mczerski/MySXActuator/exports/MySXActuator.png

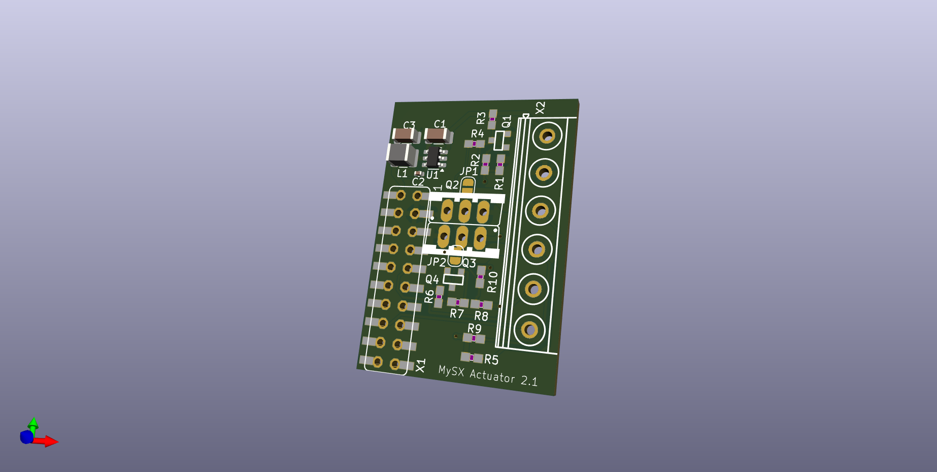
exports/MySXActuator.png
