mczerski/MySXActuator/3dshapes/G5RL_U1A_E.step

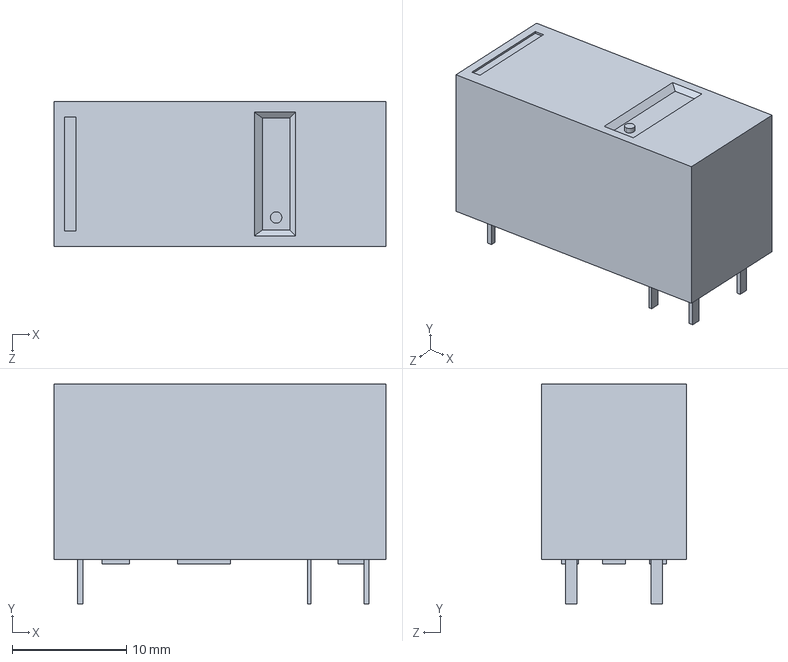
[picture p2: CAD file, 2024-06-08]
3dshapes/G5RL_U1A_E.step
29.0 x 19.2 x 12.7 mm
