mczerski/MySXActuator/3dshapes/54601-908WPLF.step

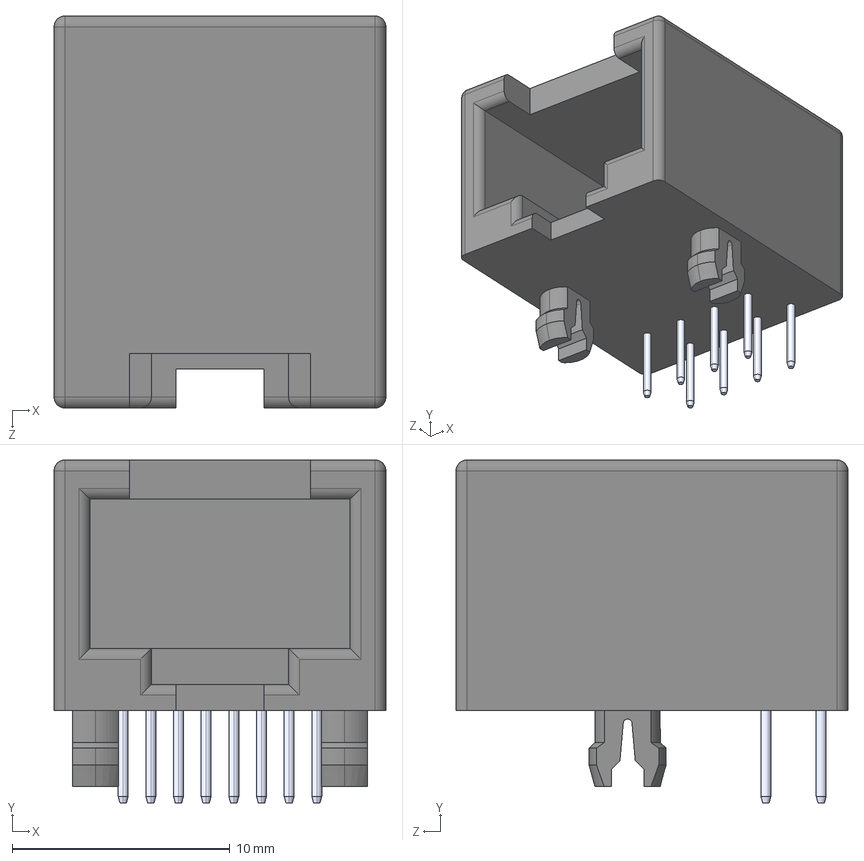
[picture p3: CAD file, 2024-07-27]
3dshapes/54601-908WPLF.step
15.2 x 15.8 x 18.0 mm
