mczerski/MySXActuator/MySXActuator.pdf

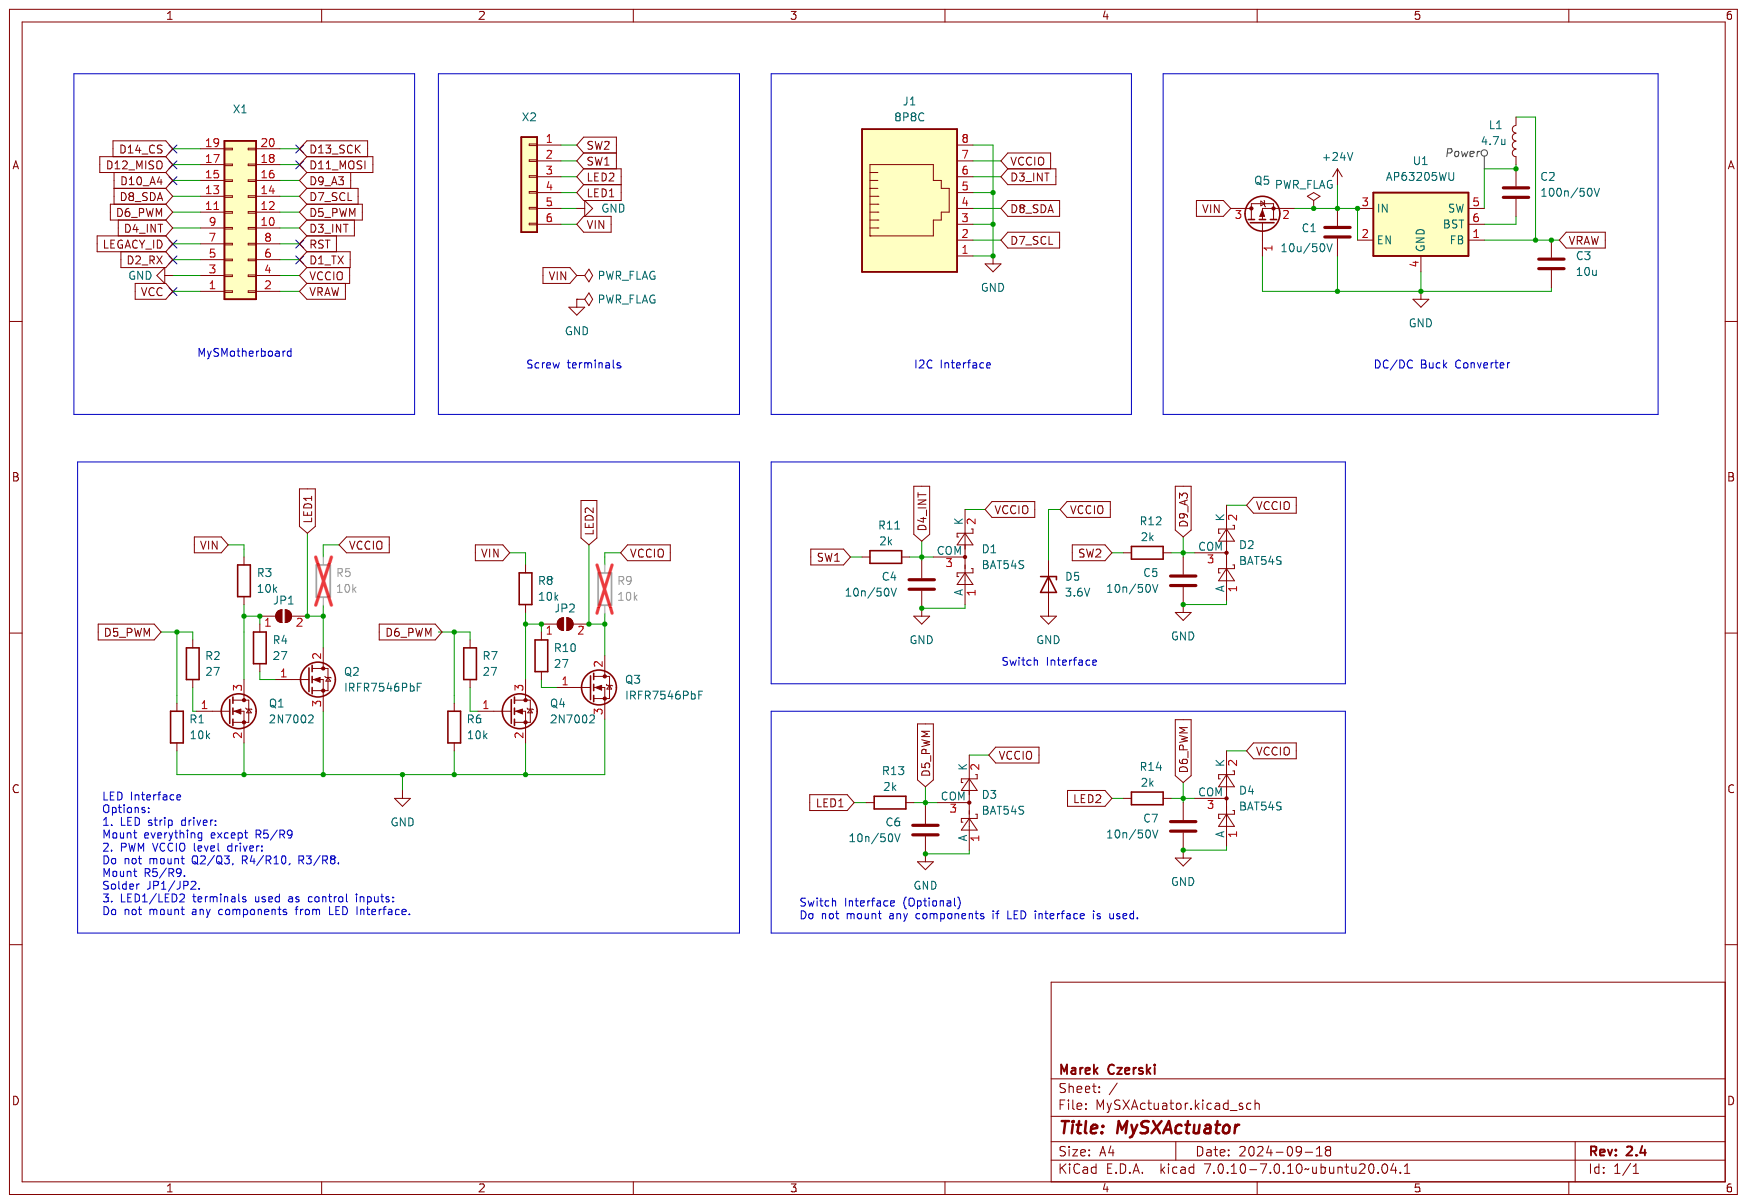
[picture p4: page 1]
