mczerski/MySXActuator/MySXActuator.kicad_pcb

## KiCad design MySXActuator.kicad_pcb (2026-06-14)

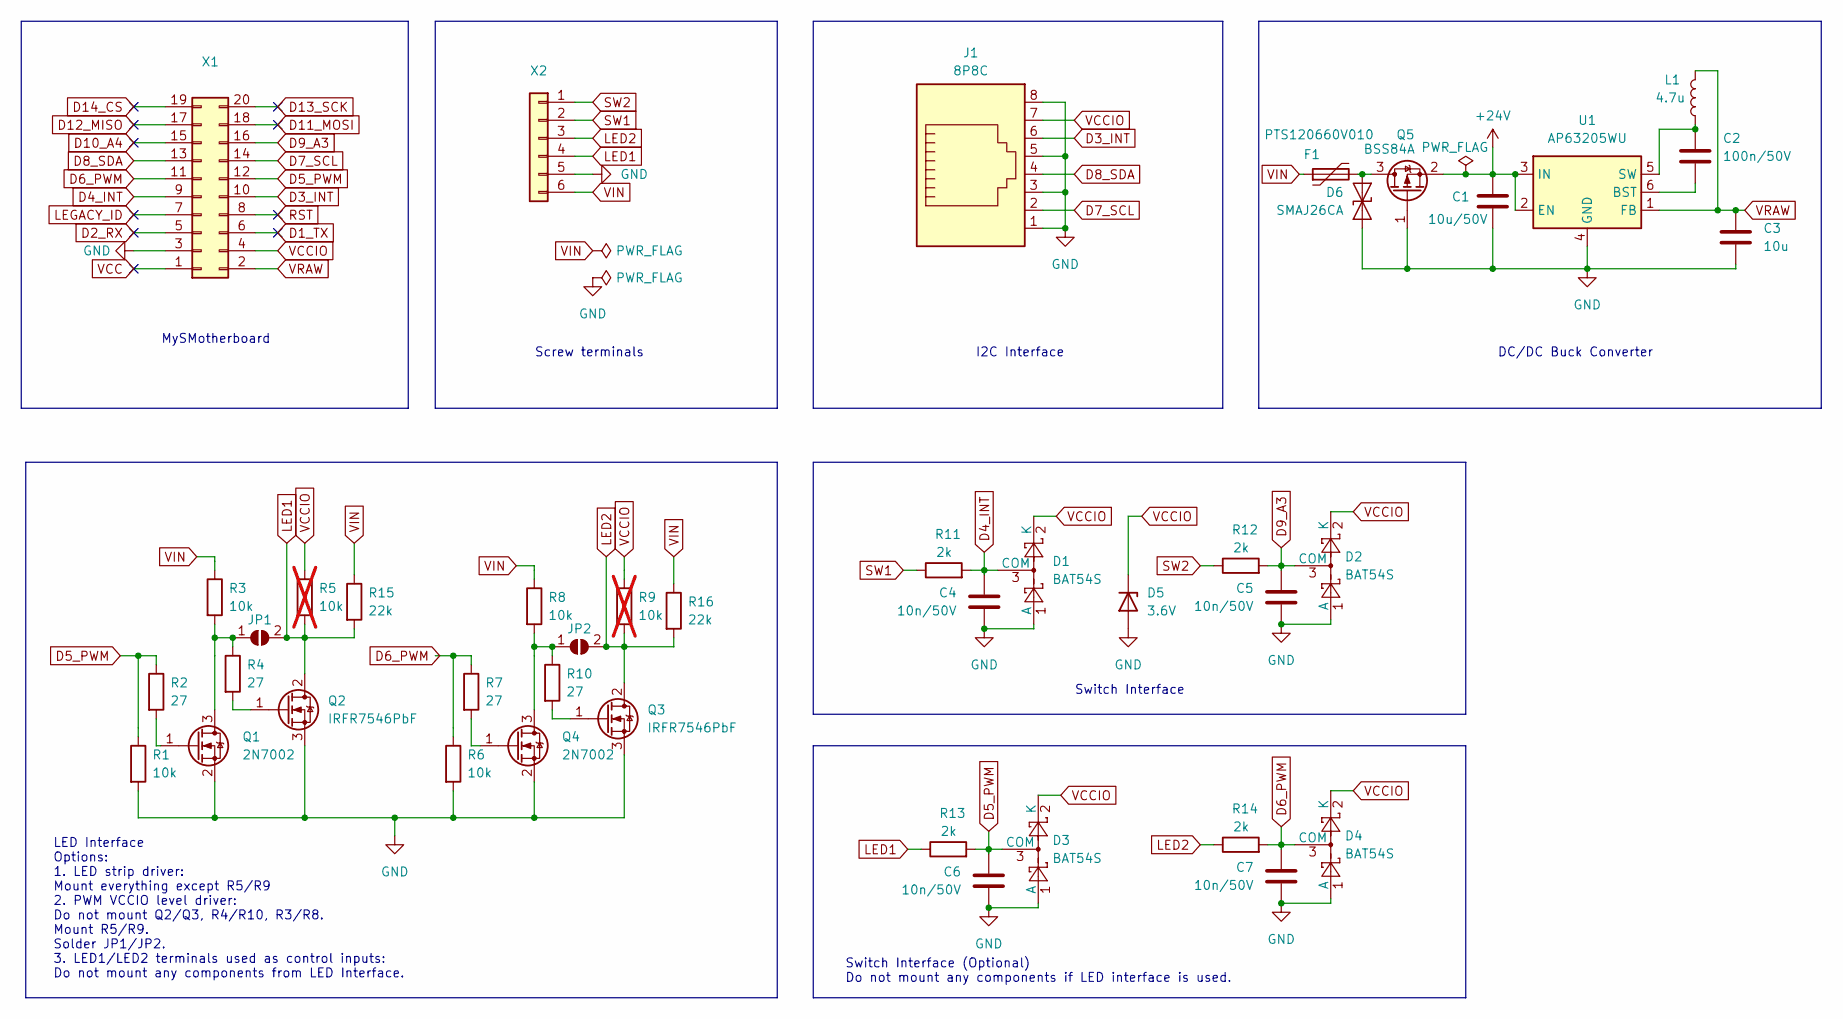
[picture p5: schematic MySXActuator.kicad_sch]

Parts:
C1: 10u/50V; C_1206_3216Metric
C2: 100n/50V; C_0402_1005Metric_Pad0.74x0.62mm_HandSolder
C3: 10u; C_1206_3216Metric
C4, C5, C6, C7: 10n/50V; C_0402_1005Metric
D1, D2, D3, D4: BAT54S; SOT-23
D5: 3.6V; D_MiniMELF
D6: SMAJ26CA; D_SMA
F1: PTS120660V010; Fuse_1206_3216Metric_Pad1.42x1.75mm_HandSolder
J1: 8P8C; AMPHENOL_54601-908WPLF
JP1, JP2: SolderJumper-2_P1.3mm_Open_RoundedPad1.0x1.5mm
L1: 4.7u; L_1210_3225Metric
Q1, Q4: 2N7002; SOT-23
Q2, Q3: IRFR7546PbF; TO-252-2
Q5: BSS84A; SOT-23
R1, R3, R6, R8: 10k; R_0603_1608Metric
R2, R4, R7, R10: 27; R_0603_1608Metric
R5, R9: 10k; R_0603_1608Metric; not fitted
R11, R12, R13, R14: 2k; R_0603_1608Metric
R15, R16: 22k; R_0603_1608Metric
U1: AP63205WU; TSOT-23-6
X1: FE10-2
X2: TerminalBlock_Phoenix_MKDS-1,5-6-5.08_1x06_P5.08mm_Horizont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

Connections:
+24V: C1.1, Q5.2 (S), U1.2 (EN), U1.3 (IN)
D1_TX: X1.6
D2_RX: X1.5
D3_INT: J1.6, X1.10
D4_INT: C4.1, D1.3 (COM), R11.2, X1.9
D5_PWM: C6.1, D3.3 (COM), R1.1, R2.1, R13.2, X1.12
D6_PWM: C7.1, D4.3 (COM), R6.1, R7.1, R14.2, X1.11
D7_SCL: J1.2, X1.14
D8_SDA: J1.4, X1.13
D9_A3: C5.1, D2.3 (COM), R12.2, X1.16
D10_A4: X1.15
D11_MOSI: X1.18
D12_MISO: X1.17
D13_SCK: X1.20
D14_CS: X1.19
GND: C1.2, C3.2, C4.2, C5.2, C6.2, C7.2, D1.1 (A), D2.1 (A), D3.1 (A), D4.1 (A), D5.2 (A), D6.1 (A1), J1.1, J1.3, J1.5, J1.8, Q1.2 (S), Q2.3 (S), Q3.3 (S), Q4.2 (S), Q5.1 (G), R1.2, R6.2, U1.4 (GND), X1.3, X2.5
LED1: JP1.2 (B), Q2.2 (D), R5.2, R13.1, R15.2, X2.4
LED2: JP2.2 (B), Q3.2 (D), R9.2, R14.1, R16.2, X2.3
LEGACY_ID: X1.7
unnamed: D6.2 (A2), F1.2, Q5.3 (D)
unnamed: JP1.1 (A), Q1.3 (D), R3.2, R4.1
unnamed: JP2.1 (A), Q4.3 (D), R8.2, R10.1
unnamed: Q1.1 (G), R2.2
unnamed: Q2.1 (G), R4.2
unnamed: Q3.1 (G), R10.2
unnamed: Q4.1 (G), R7.2
unnamed: C2.1, U1.6 (BST)
unnamed: C2.2, L1.1, U1.5 (SW)
RST: X1.8
SW1: R11.1, X2.2
SW2: R12.1, X2.1
VCC: X1.1
VCCIO: D1.2 (K), D2.2 (K), D3.2 (K), D4.2 (K), D5.1 (K), J1.7, R5.1, R9.1, X1.4
VIN: F1.1, R3.1, R8.1, R15.1, R16.1, X2.6
VRAW: C3.1, L1.2, U1.1 (FB), X1.2

Notes on the sheet:
I2C Interface
LED Interface Options: 1. LED strip driver: Mount everything except R5/R9 2. PWM VCCIO level driver: Do not mount Q2/Q3, R4/R10, R3/R8. Mount R5/R9. Solder JP1/JP2. 3. LED1/LED2 terminals used as control inputs: Do not mount any components from LED Interface.
Switch Interface
Switch Interface (Optional) Do not mount any components if LED interface is used.
DC/DC Buck Converter
Screw terminals
MySMotherboard

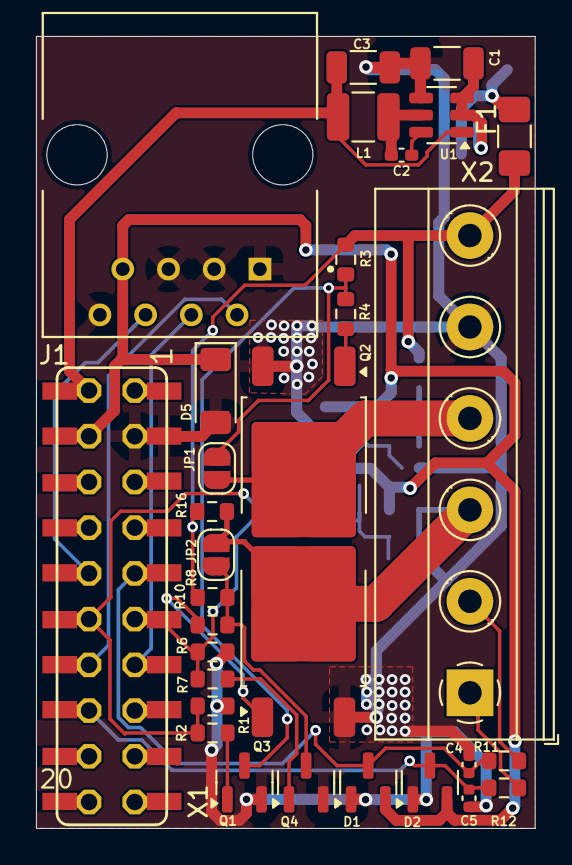
[picture p6: board MySXActuator.kicad_pcb from above]

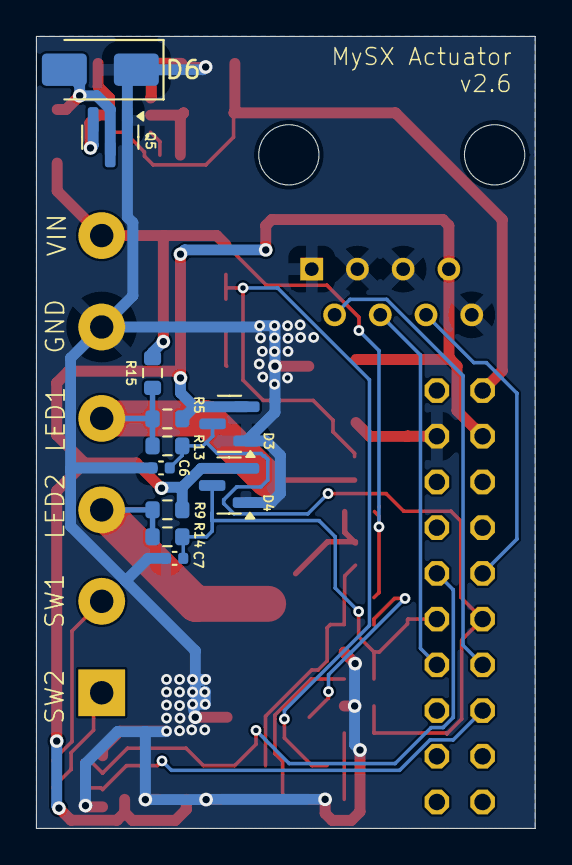
[picture p7: board MySXActuator.kicad_pcb from below]

Board: 2 copper layers, 27.7 x 44.0 mm, 42 parts (11 on the bottom side), 25 nets.
