mczerski/MySXActuator/(commit log)

2019-03-27 initial commit, v1.0
    [MySXActuator.brd, MySXActuator.sch]
2019-03-27 remove transistor value
    [MySXActuator.brd]
2019-03-31 enlarge traces widths + add ldo
    [MySXActuator.brd, MySXActuator.sch]
2019-04-03 add second dimmer
    [MySXActuator.brd, MySXActuator.sch]
2019-04-04 fix stencil
    [MySXActuator.brd]
2024-05-04 imported from eagle, ldo changed to buck converter
    [MySXActuator.kicad_pcb, MySXActuator.kicad_sch]
2024-05-05 change C2 footprint from 0201 to 0402
    [MySXActuator.kicad_pcb, MySXActuator.kicad_sch]
2024-05-05 add screenshot of the board
2024-05-25 refactor schematic to use kicad native symbols and footprints
    [MySXActuator.kicad_pcb, MySXActuator.kicad_sch]
2024-06-08 add reverse polarity protection and overvoltage protection for input pins
    [G5RL_U1A_E.step, MySXActuator.kicad_pcb, MySXActuator.kicad_sch]
2024-07-26 add schematic export
2024-07-27 update schematic
    - add zener diode to protect high positive voltage on inputs
    - add anoter 2 input sections as alternative to led drivers
    - add add rj45 socket for i2c interface
    [54601-908WPLF.step, MySXActuator.kicad_pcb, MySXActuator.kicad_sch]
2024-07-27 update PCB after schematic changes
    [MySXActuator.kicad_pcb, MySXActuator.kicad_sch]
2024-09-18 Add removed buck converter
    - previously removed buck converter is needed to not require power from
    RS485 line
    - position RJ45 connector closer to center of the board to allow use
    straigth connector (facing up)
    - replace THT power transistors with SMT power transistors
    [MySXActuator.kicad_pcb, MySXActuator.kicad_sch]
2026-04-12 update to new kicad version 8.0
    [MySXActuator.kicad_pcb, MySXActuator.kicad_sch]
2026-06-11 add input voltage transient protection
    [MySXActuator.kicad_pcb, MySXActuator.kicad_sch]
2026-06-14 add resistors to prevent led glowing when turned off
    [MySXActuator.kicad_pcb, MySXActuator.kicad_sch]
